AndreElectronics/TTL-PIC-PLL-Frequency-Synthesizer/media/lab-imgs/3.4. 16F628A pinout.png

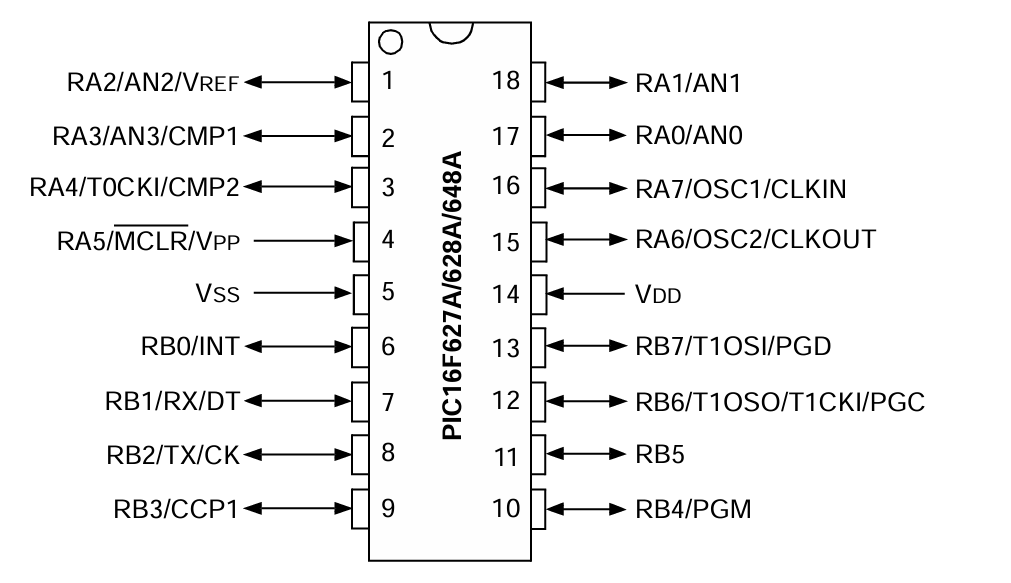
media/lab-imgs/3.4. 16F628A pinout.png
