AndreElectronics/TTL-PIC-PLL-Frequency-Synthesizer/media/lab-imgs/5.1. Circuito.jpg

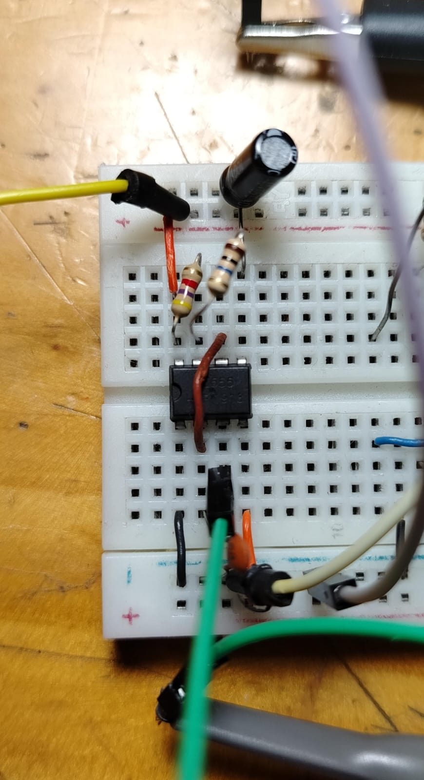
media/lab-imgs/5.1. Circuito.jpg
