AndreElectronics/TTL-PIC-PLL-Frequency-Synthesizer/media/lab-imgs/5.1. Osciloscopio del circuito.jpg

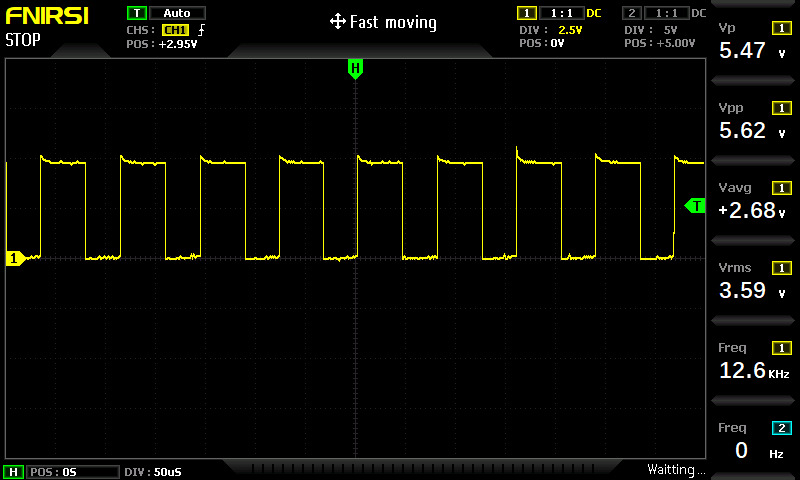
media/lab-imgs/5.1. Osciloscopio del circuito.jpg
