AndreElectronics/TTL-PIC-PLL-Frequency-Synthesizer/media/lab-imgs/5.2. Cirucito con PIC.jpg

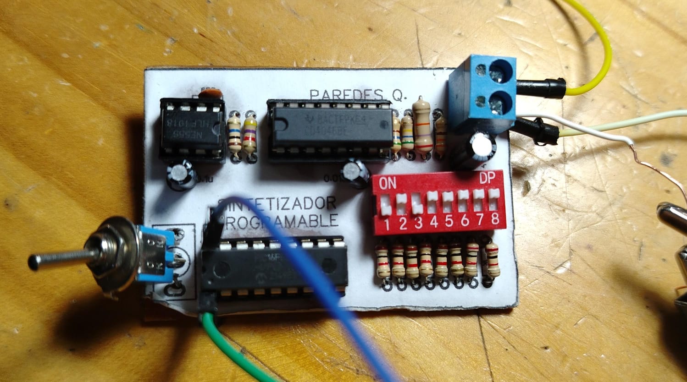
media/lab-imgs/5.2. Cirucito con PIC.jpg
