AndreElectronics/TTL-PIC-PLL-Frequency-Synthesizer/media/lab-imgs/5.2. Salida del circuito.jpg

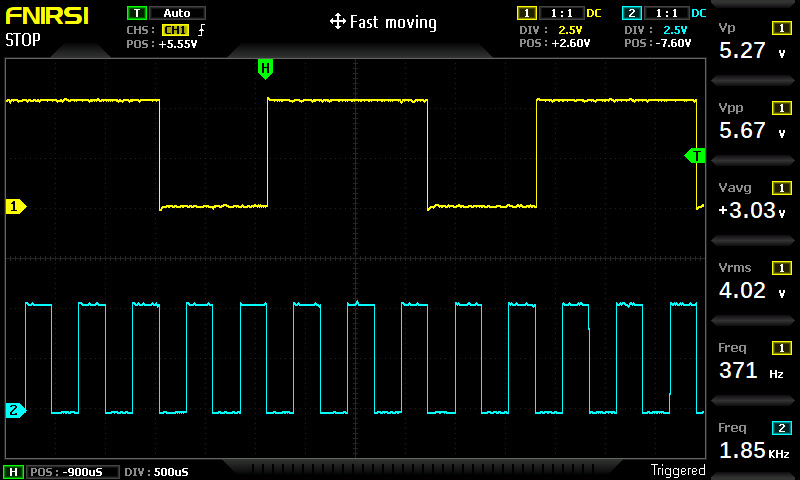
media/lab-imgs/5.2. Salida del circuito.jpg
