AndreElectronics/TTL-PIC-PLL-Frequency-Synthesizer/media/lab-imgs/ANEXO PCB.jpg

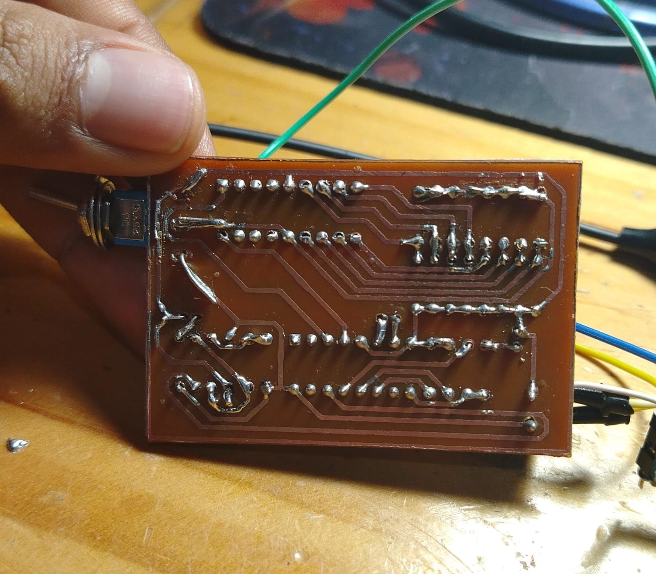
media/lab-imgs/ANEXO PCB.jpg
