AndreElectronics/TTL-PIC-PLL-Frequency-Synthesizer/hardware/pcb/PCB_PCB_Sintetizador_2025-09-19.pdf

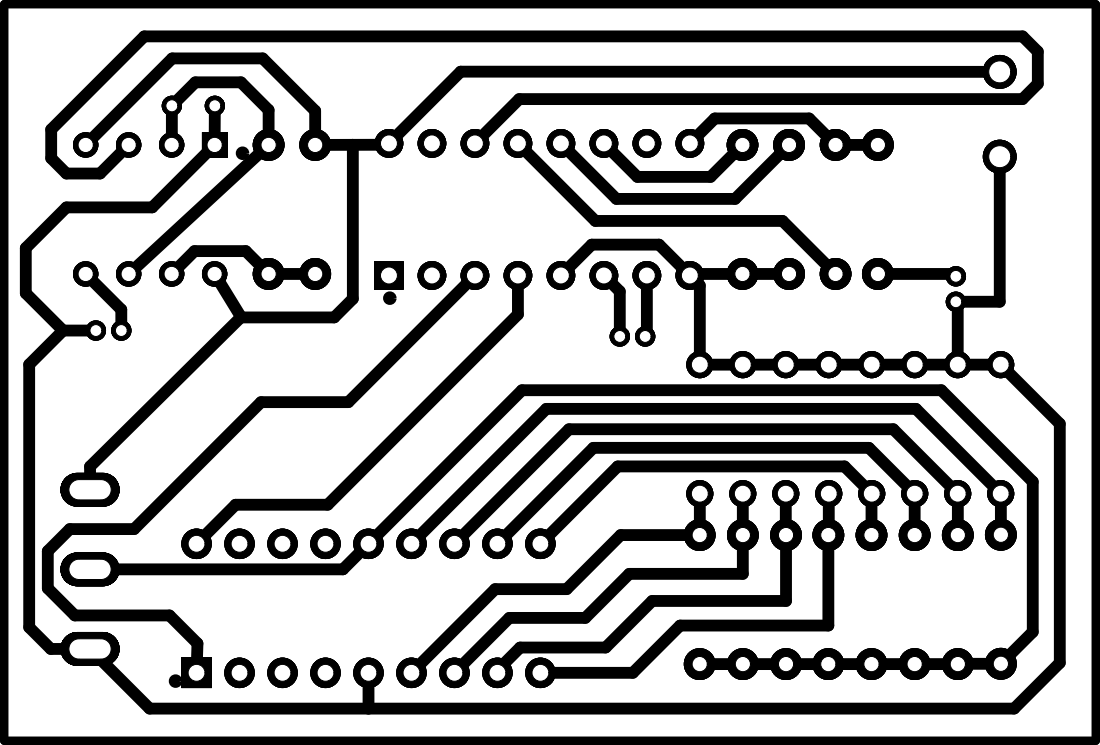
[picture p28: page 1]

PAREDES Q.

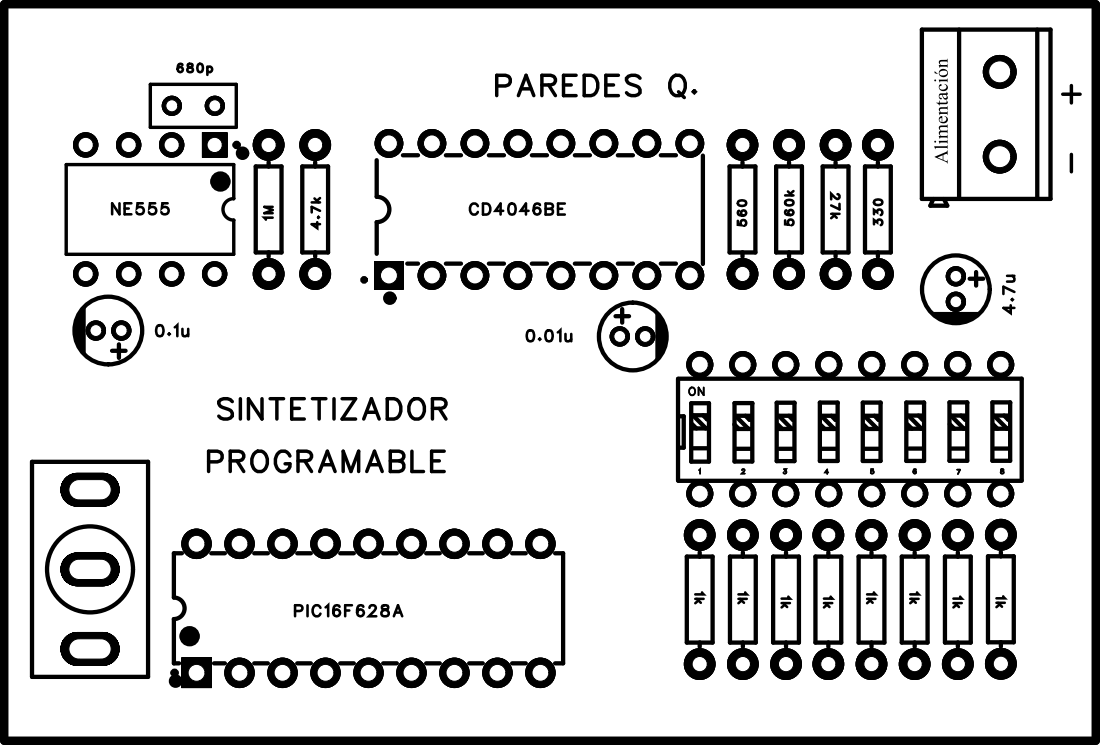
[picture p29: page 2]
