AndreElectronics/TTL-PIC-PLL-Frequency-Synthesizer/hardware/pcb/PCB_Sintetizador_COPPER.pdf

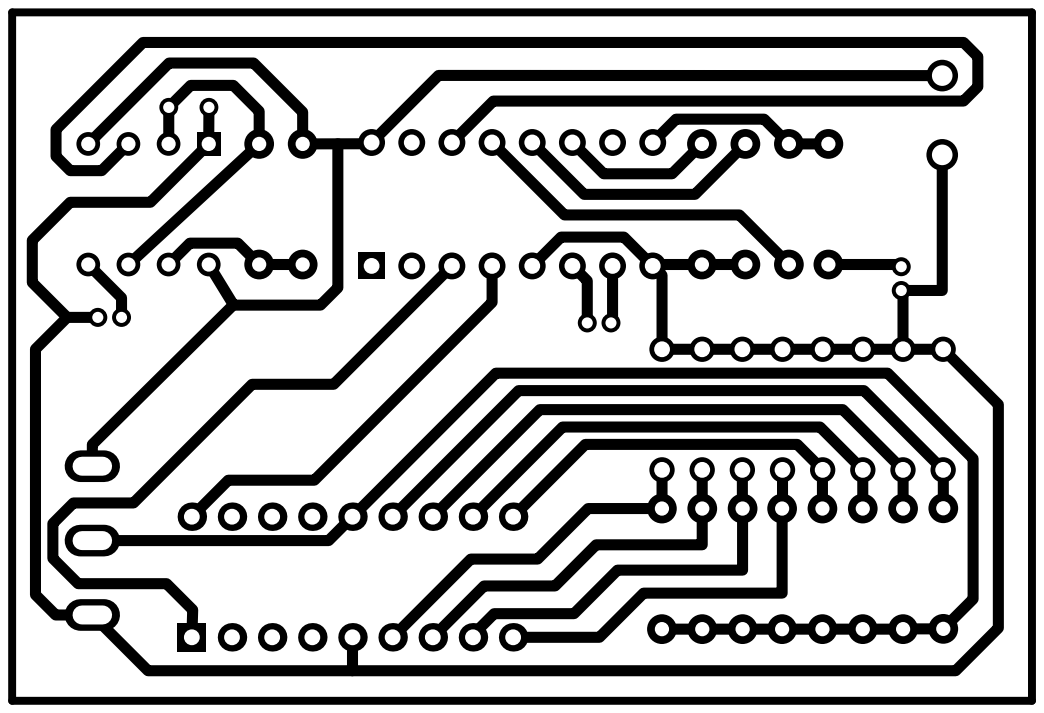
[picture p30: page 1]
