AndreElectronics/TTL-PIC-PLL-Frequency-Synthesizer/hardware/pcb/PCB_Sintetizador_COPPER2.pdf

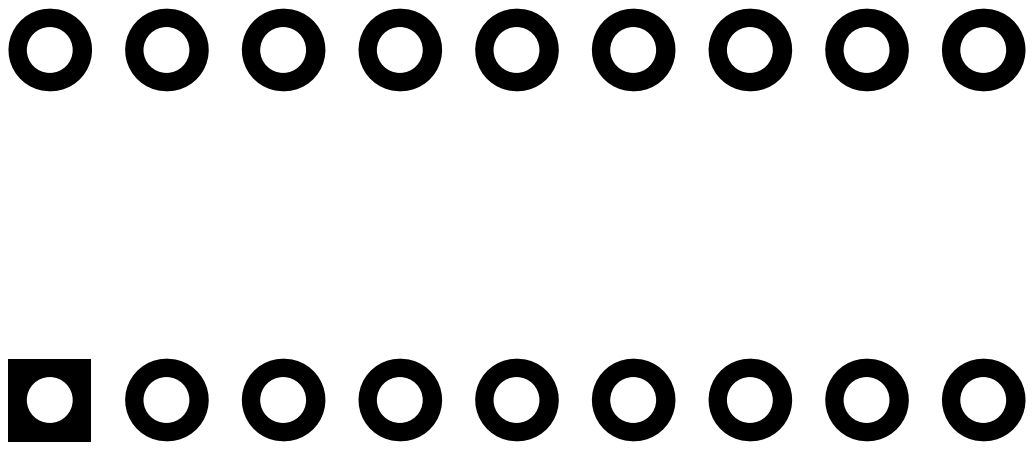
[picture p31: page 1]
