AndreElectronics/TTL-PIC-PLL-Frequency-Synthesizer/hardware/pcb/PCB_Sintetizador_SILK.pdf

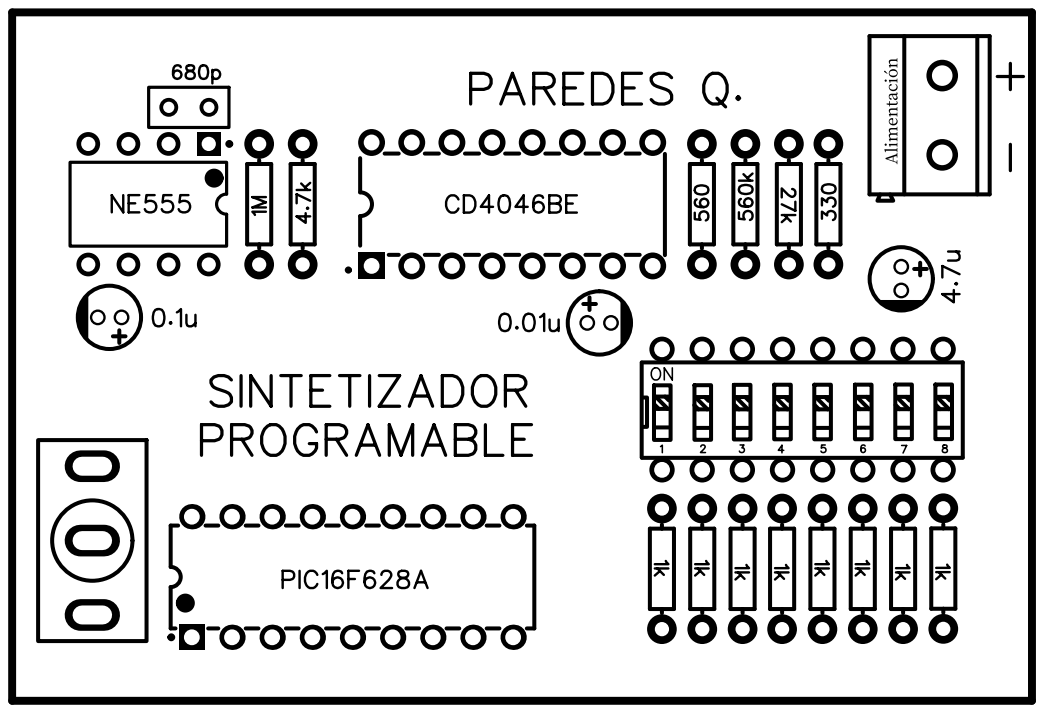
[picture p32: page 1]
