AndreElectronics/TTL-PIC-PLL-Frequency-Synthesizer/hardware/schematics/SCH_Schematic_Sintetizador_2025-09-19.pdf

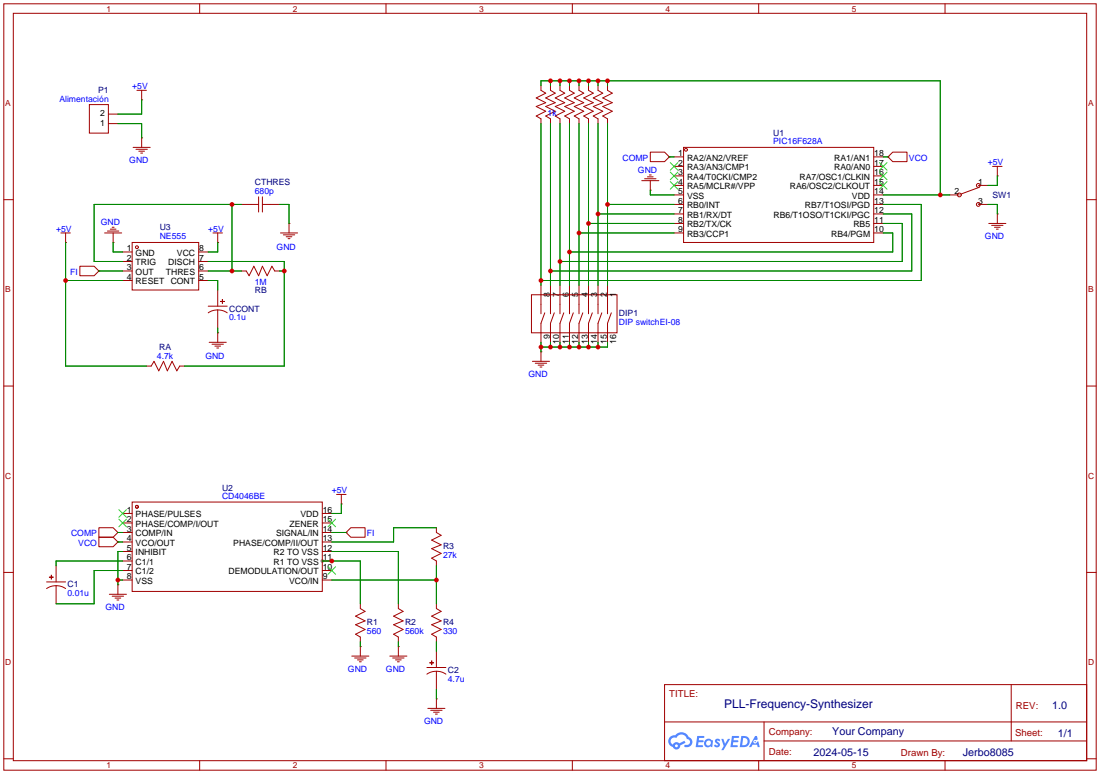
[picture p33: page 1]

PIC16F628A
RB4/PGM 10 RB5 11 RB6/T1OSO/T1CKI/PGC 12 RB7/T1OSI/PGD 13 VDD 14 RA6/OSC2/CLKOUT 15 RA7/OSC1/CLKIN 16 RA0/AN0 17 RA1/AN1 18

DEMODULATION/OUT 10 R1 TO VSS 11 R2 TO VSS 12 PHASE/COMP/II/OUT 13 SIGNAL/IN 14 ZENER 15 VDD 16
