AndreElectronics/TTL-PIC-PLL-Frequency-Synthesizer/(list of files, drawings)

Other design files:
simulations/proteus/Project Backups/Sintetizador_7493 [20250919, 21-42-42].pdsprj
simulations/proteus/Project Backups/Sintetizador_7493 [20250919, 21-43-26].pdsprj
simulations/proteus/Project Backups/Sintetizador_PIC16F628A [20250919, 21-53-07].pdsprj
simulations/proteus/Project Backups/Sintetizador_PIC16F628A [20250919, 22-26-13].pdsprj
simulations/proteus/Sintetizador_7493.pdsprj
simulations/proteus/Sintetizador_PIC16F628A.pdsprj
